RAJ-IITROORKEE/smart-park-design/media/README.md

# SmartPark media

The showcase folder contains a short product film made from the actual RevD CAD previews. The videos folder retains the supplied screen recording unchanged.

## Product showcase

The film presents the final enclosure, carrier and connected electronics, followed by the two case variants and fabrication downloads.

- [Showcase MP4](showcase/brag.mp4)
- [Full resolution poster](showcase/brag.jpg)
- [Animated README preview](showcase/preview.gif)
- [Storyboard and source composition](showcase)

These visuals show the design intent of an unbuilt indoor pilot, not a deployed working product. Music attribution and reproduction details are retained with the composition.

## Original recording

The original supplied project recording is preserved without editing or recompression.

- [SmartPark RevD recording](videos/smartpark-revd-preview.mp4)
- Original filename: `20261026-1720-29.8333173.mp4`
- Copy integrity: [SHA256 verification](../verification/video-copy.json)

The recording is a project media asset. Its contents have not been reviewed for public sharing; inspect it before a future GitHub publication.
