RAJ-IITROORKEE/smart-park-design/lat.md/lat.md

# SmartPark Rev D knowledge index

This index links the project overview, manufacturing flow, and pilot qualification limits.

- [[index]] — Architecture, geometry checks, and electrical source overview.
