RAJ-IITROORKEE/smart-park-design/media/showcase/brag-plan.md

# Brag Plan: SmartPark Revision D

## Planning rubric

1. **What is this?** An indoor ceiling-mounted parking sensor pilot built around a downward-facing HC-SR04, XIAO ESP32S3, and a custom carrier.
2. **Strongest claim:** The design is dimensioned for a ceiling up to 2.8 m above the floor; this is a design limit, not a field-test result.
3. **Visual hook:** The actual assembled CAD render, with its two ultrasonic faces and compact enclosure.
4. **What to show:** Actual product, electronics stack, OLED/status-only variants, PCB copper, and the repository’s fabrication and print downloads.
5. **Shortest satisfying length:** 20.5 seconds: enough for the product, the two build variants, and where to get the design files.
6. **Tone:** Polished; a restrained engineering product film with legible labels and precise motion.
7. **Audio:** A clean instrumental bed with three quiet, motion-matched accents; no narration.
8. **Share caption:** “SmartPark Rev D: an indoor ceiling-mounted parking sensor pilot, with the PCB and case files ready to inspect.”
9. **Real use flow:** Not a software flow. The designed sequence is mount above a bay → measure downward with HC-SR04 → report occupancy over LoRa to a separate receiver/gateway. Firmware and gateway are not included.

## The angle

A precise object study of one indoor parking bay sensor: the finished-looking enclosure opens into its actual electronics, resolves into two real case variants, then lands on the PCB and the build files. The footage presents the retained design as an unbuilt pilot, not a deployed or qualified product.

## Hook (0–3.2s)

Lead with the supplied product_oled.png CAD render. “One bay. Read from above.” appears beside it over a pale technical canvas. The top line identifies SmartPark Rev D and labels the work an indoor pilot.

## Key moments

- The supplied status-only housing and a dimension marker anchor the 2.8 m indoor ceiling design envelope.
- The real exploded enclosure and electronics-stack renders show how the carrier, modules, battery, and case relate.
- Two actual case renders arrive in sequence: OLED (7 printed parts), then status-only (6 printed parts).
- The actual PCB front/back previews lead to Gerbers, KiCad sources, and case-print files.

## Outro

Show the real PCB copper views, then hold the repository address with “Rev D · indoor pilot” and “Unbuilt design · firmware and gateway not included.”

## Tone and format

- Preset: polished
- Creative direction: calm, measured engineering product film
- Interpretation: long enough to inspect the real models; crisp type, short labels, restrained teal accents, and motion that feels deliberate rather than dramatic.
- Format: landscape — 1920 × 1080
- Duration: 20.5 seconds
- Visual identity: cool light background #EEF3F5; navy #183849; teal #168B8D; body #395461; fine rules #A9BEC3.
- Display font: Playfair Display; body: Montserrat; technical labels: IBM Plex Mono.
- Strongest source visuals: the supplied CAD assembly and PCB copper renders in previews/05-images/ and previews/01-pcb/.
- No live app UI exists. The product visual is the source CAD.
- Claims to avoid: built, deployed, production-ready, weatherproof/IP-rated, measured battery life, working firmware, included gateway, field performance.

## Share copy (draft)

SmartPark Rev D: an indoor ceiling-mounted parking sensor pilot, with the PCB and case files ready to inspect.

## Audio direction

- Role: understated polished bed with a few soft reveal accents.
- Music: “Happy Beats & Business Moves Vol. 12” by Sascha Ende, copied from the bundled /brag assets.
- Music treatment: fade in briefly, sit below the product visuals, fade out on the closing card.
- Music cue guidance: bundled preset happy-beats-business-moves-vol-12-by-ende-dot-app.music-cues.json, 109.96 BPM. Lock the electronics-stack reveal near 8.74s, the second case variant near 13.11s, and PCB/download reveal near 17.47s. For the two case cards, use nearby grid beats at 12.02s and 13.11s; both labels remain visible afterward. Keep the smaller image and rule motions natural.
- Audio treatment: music sets pacing and transitions; animation stays calm and non-reactive. No waveform or equalizer graphics.
- SFX posture: sparse; three soft, warm accents on product, stack, and final PCB reveals.
- Restraint rule: music and sounds support the real objects; no hype impacts or synthetic sensor beeps.

## Storyboard

### Scene 1 — One bay — 3.2s
The actual OLED product render fills the right half; the hook and “SMARTPARK / REV D · INDOOR PILOT” sit left. A measured rule pulls the eye toward the two downward-facing sensor apertures. The headline enters quickly and holds for at least 2s.
Sequential/interaction: none.
Audio intent: music begins softly; one low, warm reveal accent.
Audio-coupled idea: subtle background warmth only.
Transition mood: clean slide → Scene 2.

### Scene 2 — Ceiling mount — 3.9s
The actual status-only product render is paired with “Designed for indoor ceilings up to 2.8 m.” A simple measurement rule clarifies the sensor-to-floor orientation without depicting a live parking result.
Sequential/interaction: none.
Audio intent: let the bed carry the hold.
Audio-coupled idea: none.
Transition mood: soft crossfade → Scene 3.

### Scene 3 — Inside the enclosure — 4.4s
The actual exploded OLED enclosure resolves into the real electronics stack. Labels name XIAO ESP32S3, Wio-SX1262, HC-SR04, and protected 1S LiPo. “62 × 50 mm carrier” describes the PCB; no assembled/operating state is implied.
Sequential/interaction: component labels appear as one readable set.
Audio intent: quiet accent on the stack reveal.
Audio-coupled idea: land the main reveal near the 8.74s strong cue.
Transition mood: clean slide → Scene 4.

### Scene 4 — Two case variants — 4.2s
The supplied OLED and status-only case renders arrive one at a time; parts-review.png supports the real printed-part layout. Captions: “OLED · 7 printed parts” and “Status-only · 6 printed parts.” The first label remains visible when the second arrives.
Sequential/interaction: OLED card at about 12.02s, status-only card near the 13.11s strong cue; keep both labels on screen through the cut.
Audio intent: one light accent on the second variant.
Audio-coupled idea: the two visual entries use the nearby cue grid without rushing text.
Transition mood: clean slide → Scene 5.

### Scene 5 — Files to build from — 4.8s
Actual PCB front/back copper renders flank “Gerbers · KiCad · case prints.” Hold github.com/RAJ-IITROORKEE/smart-park-design, “Rev D · indoor pilot,” and “Unbuilt design · firmware and gateway not included.” Music credit sits quietly in the footer.
Sequential/interaction: files arrive as one stable set.
Audio intent: final soft resolve and short music fade.
Audio-coupled idea: land the board/download reveal near 17.47s.
Transition mood: settle and hold through 20.5s.

**Music mood:** optimistic, clean, quiet under the visuals.
**Audio summary:** A soft instrumental bed follows the reveal from product to board, with three restrained accents and a short final fade.
