RAJ-IITROORKEE/smart-park-design/cad/renders/base.png

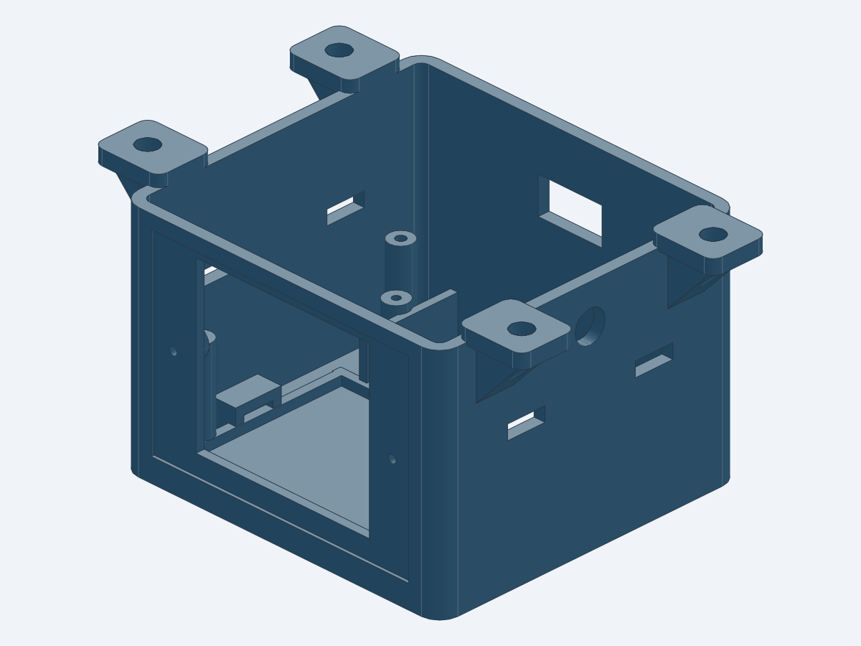
cad/renders/base.png
