RAJ-IITROORKEE/smart-park-design/cad/renders/exploded_status.png

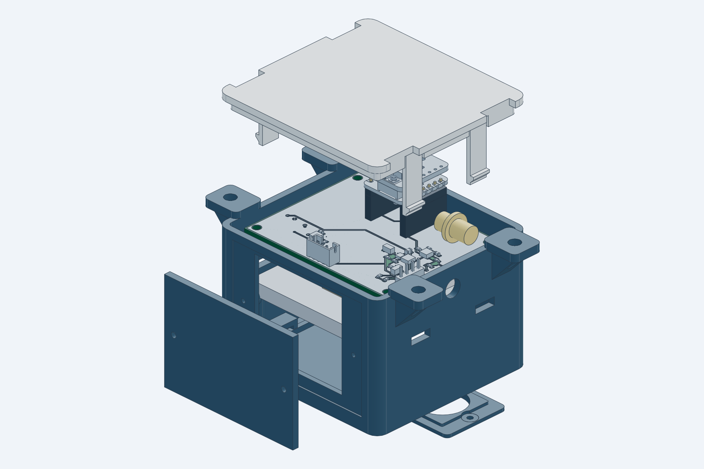
cad/renders/exploded_status.png
