RAJ-IITROORKEE/smart-park-design/cad/renders/fit_coupon.png

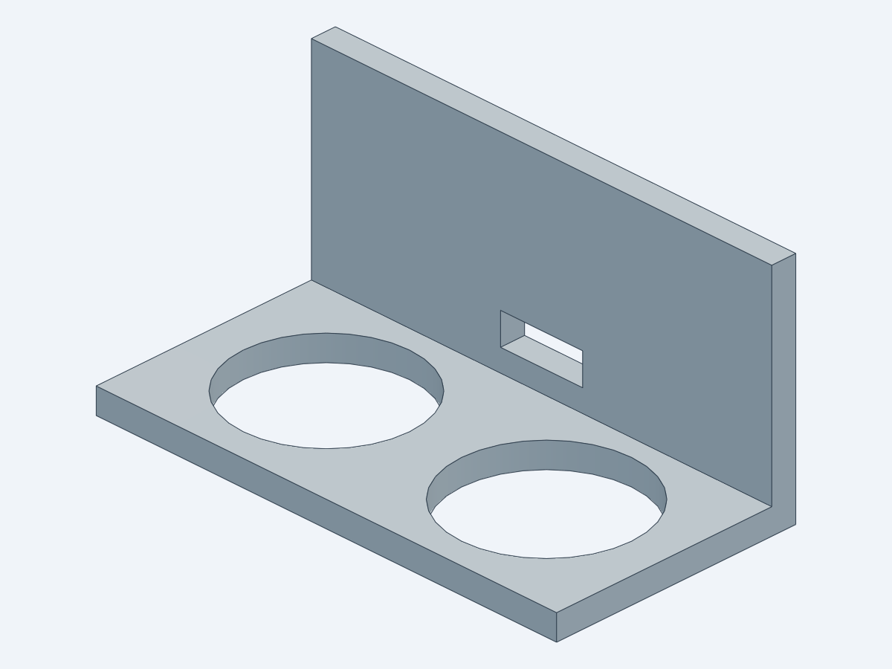
cad/renders/fit_coupon.png
