RAJ-IITROORKEE/smart-park-design/cad/renders/front_blank.png

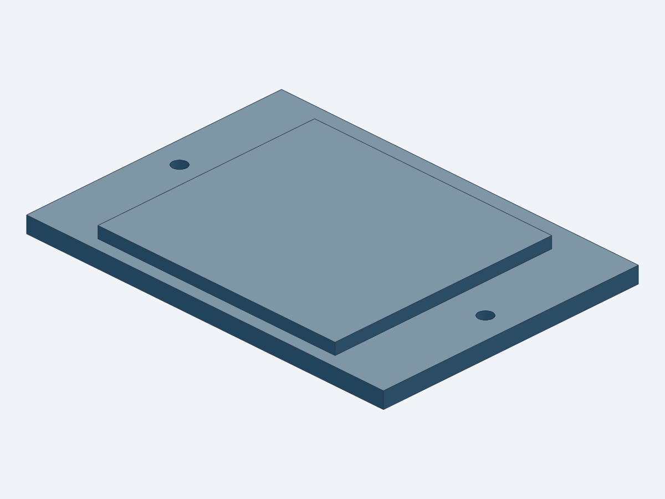
cad/renders/front_blank.png
