RAJ-IITROORKEE/smart-park-design/cad/renders/lid.png

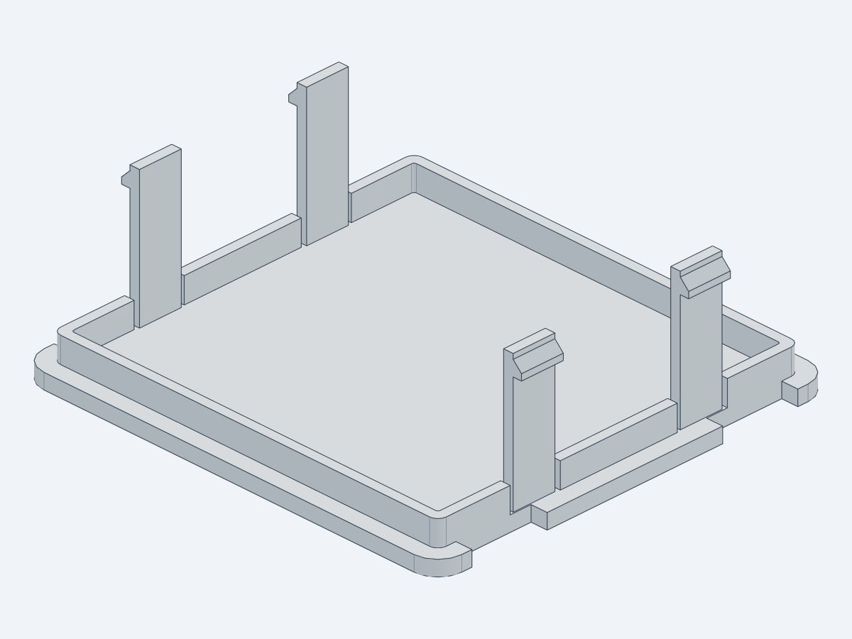
cad/renders/lid.png
