RAJ-IITROORKEE/smart-park-design/cad/renders/light_pipe.png

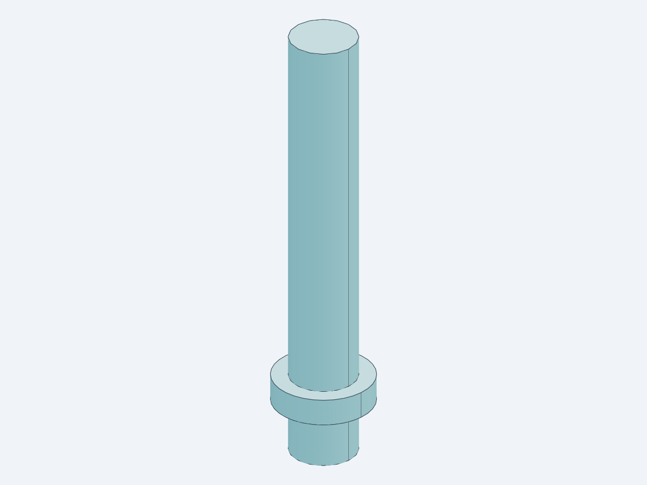
cad/renders/light_pipe.png
