RAJ-IITROORKEE/smart-park-design/cad/renders/oled_retainer.png

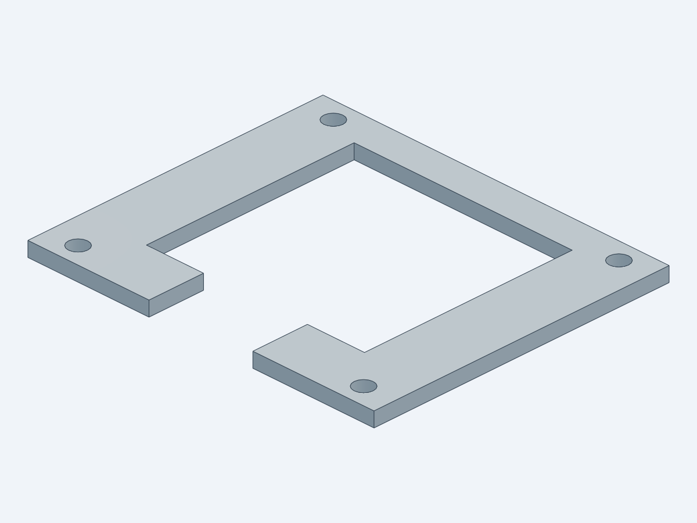
cad/renders/oled_retainer.png
