RAJ-IITROORKEE/smart-park-design/cad/renders/sensor_mask.png

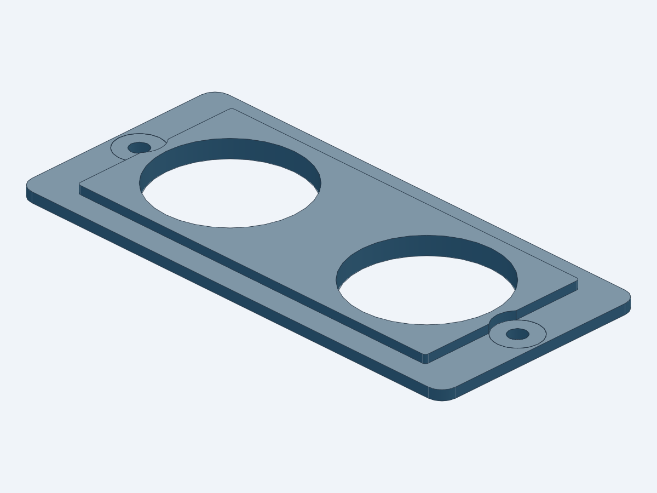
cad/renders/sensor_mask.png
