RAJ-IITROORKEE/smart-park-design/cad/renders/sensor_retainer.png

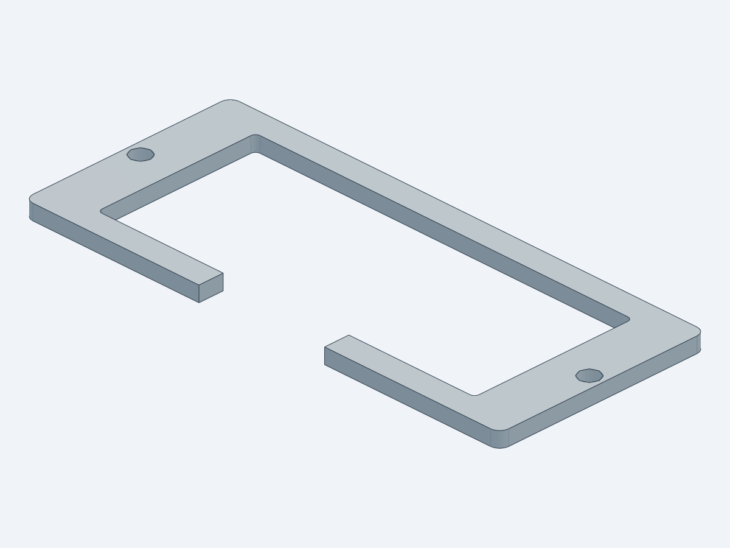
cad/renders/sensor_retainer.png
