RAJ-IITROORKEE/smart-park-design/docs/sources/goldenmorning-page4.png

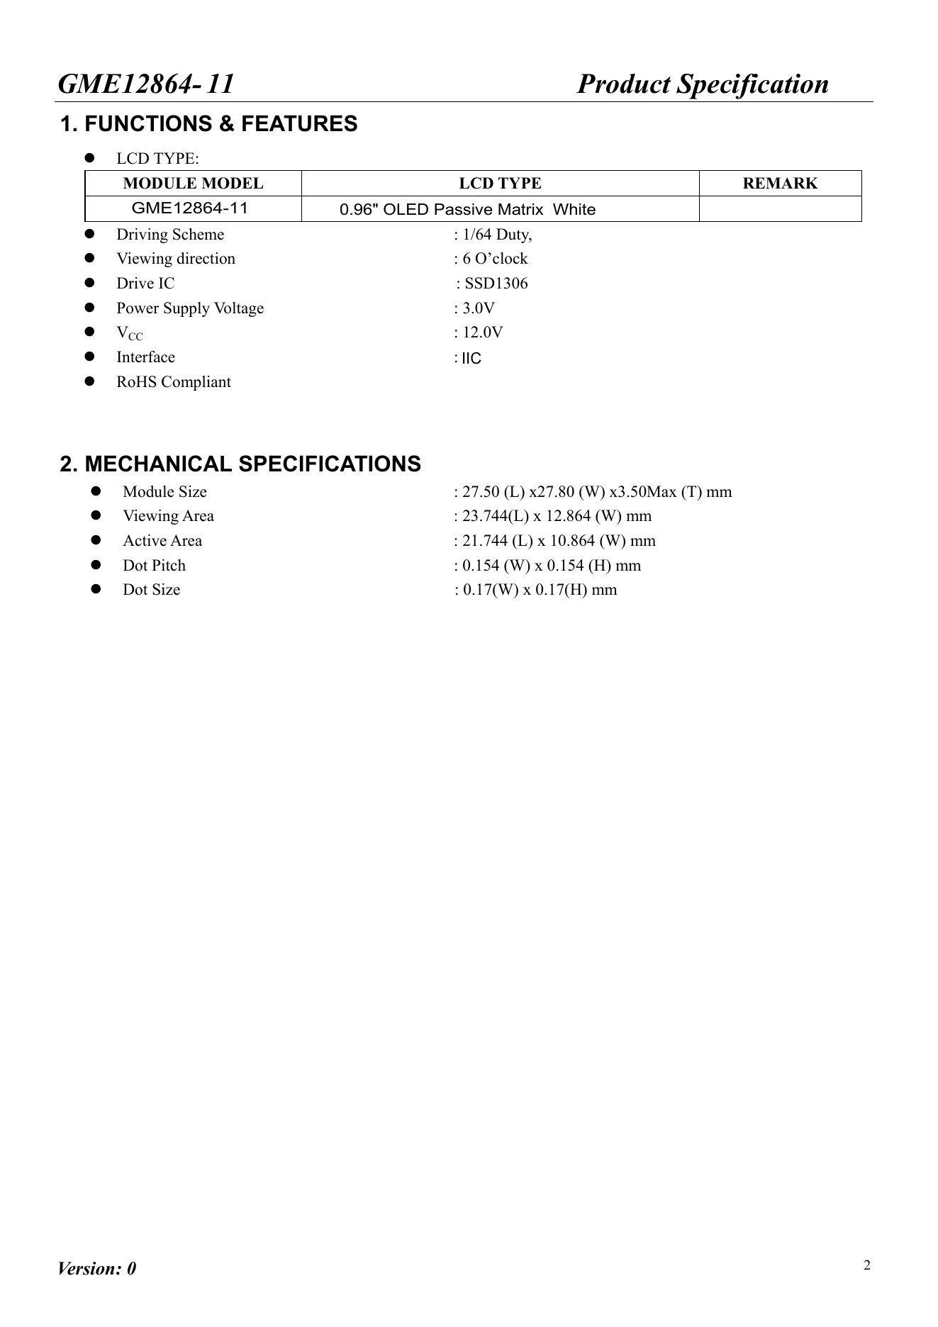
docs/sources/goldenmorning-page4.png
