RAJ-IITROORKEE/smart-park-design/docs/sources/goldenmorning-page5.png

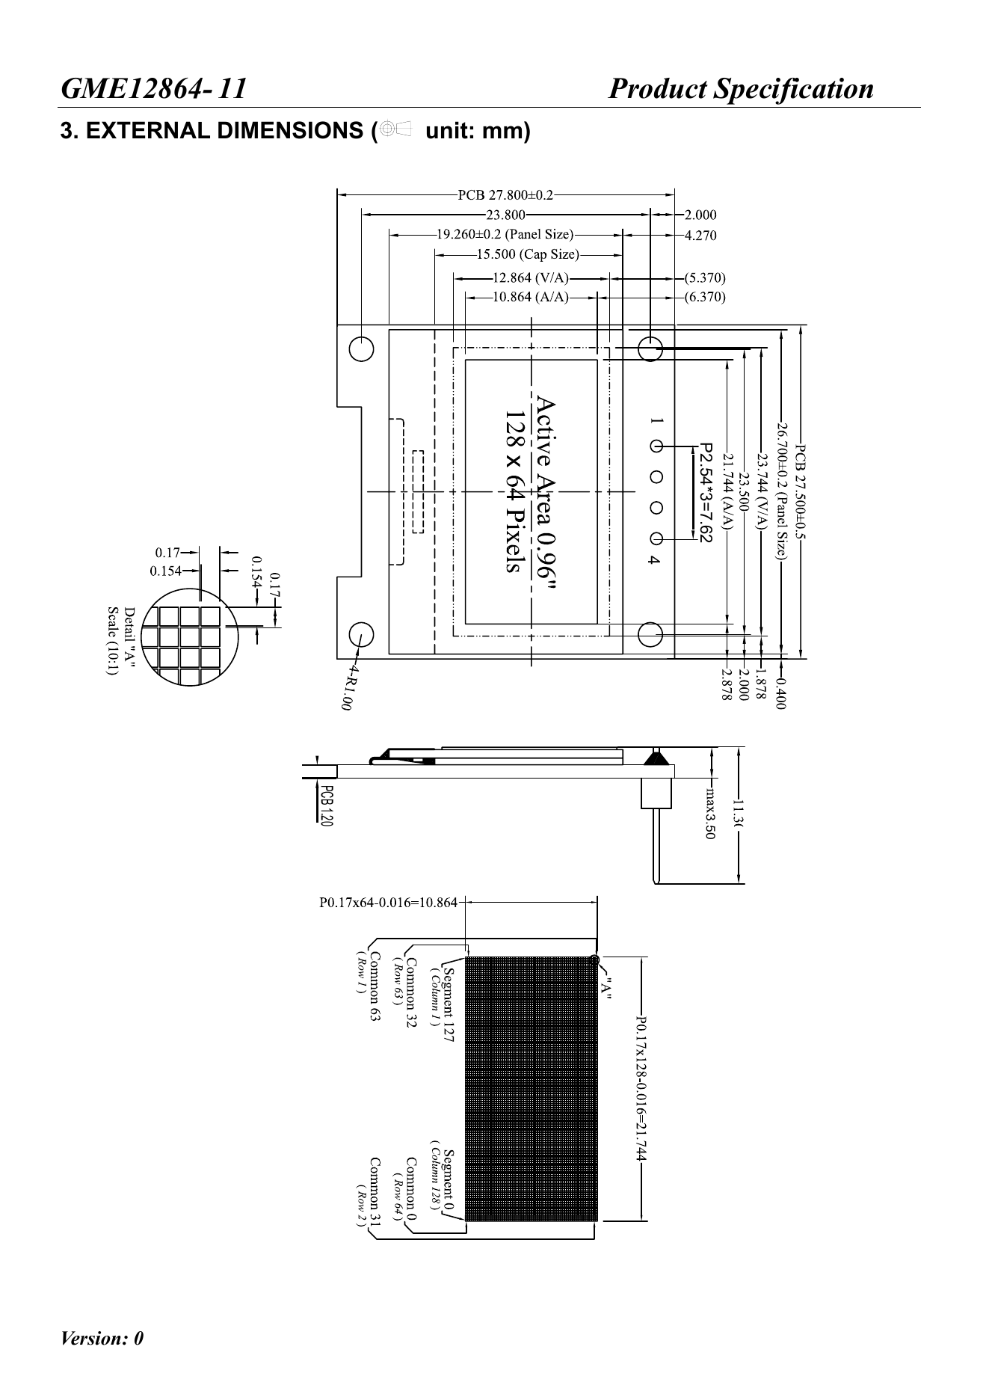
docs/sources/goldenmorning-page5.png
