RAJ-IITROORKEE/smart-park-design/docs/sources/robu-hcsr04-page1.png

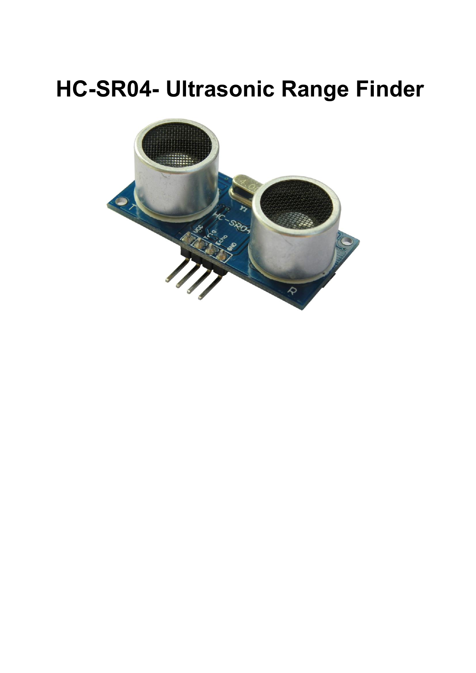
docs/sources/robu-hcsr04-page1.png
