RAJ-IITROORKEE/smart-park-design/docs/sources/robu-hcsr04-page3.png

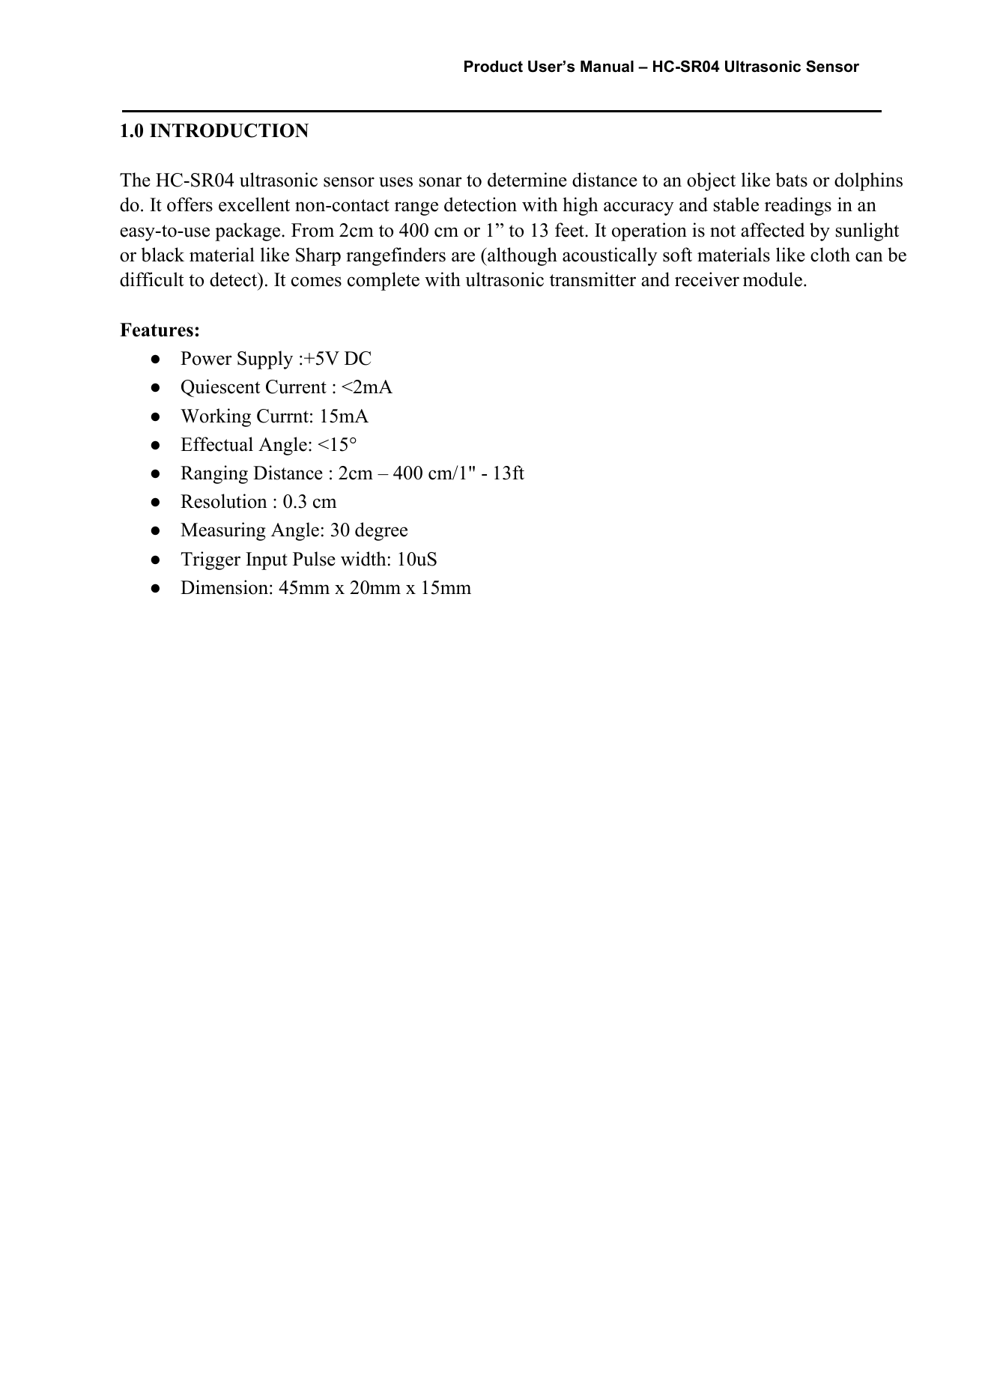
docs/sources/robu-hcsr04-page3.png
