RAJ-IITROORKEE/smart-park-design/media/showcase/brag.jpg

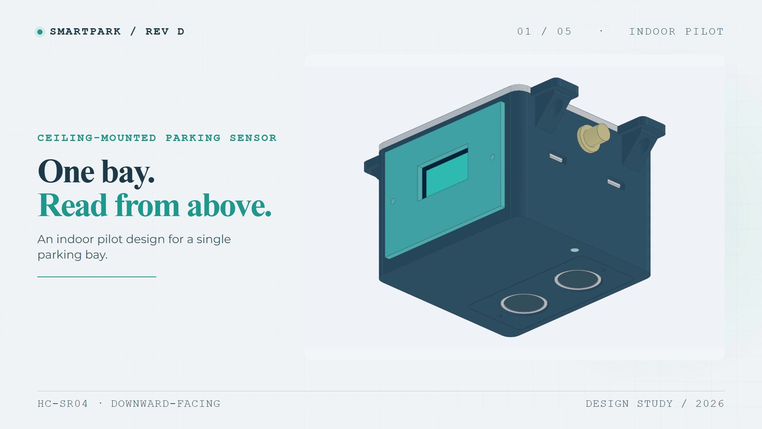
media/showcase/brag.jpg
