RAJ-IITROORKEE/smart-park-design/outputs/schematics.png

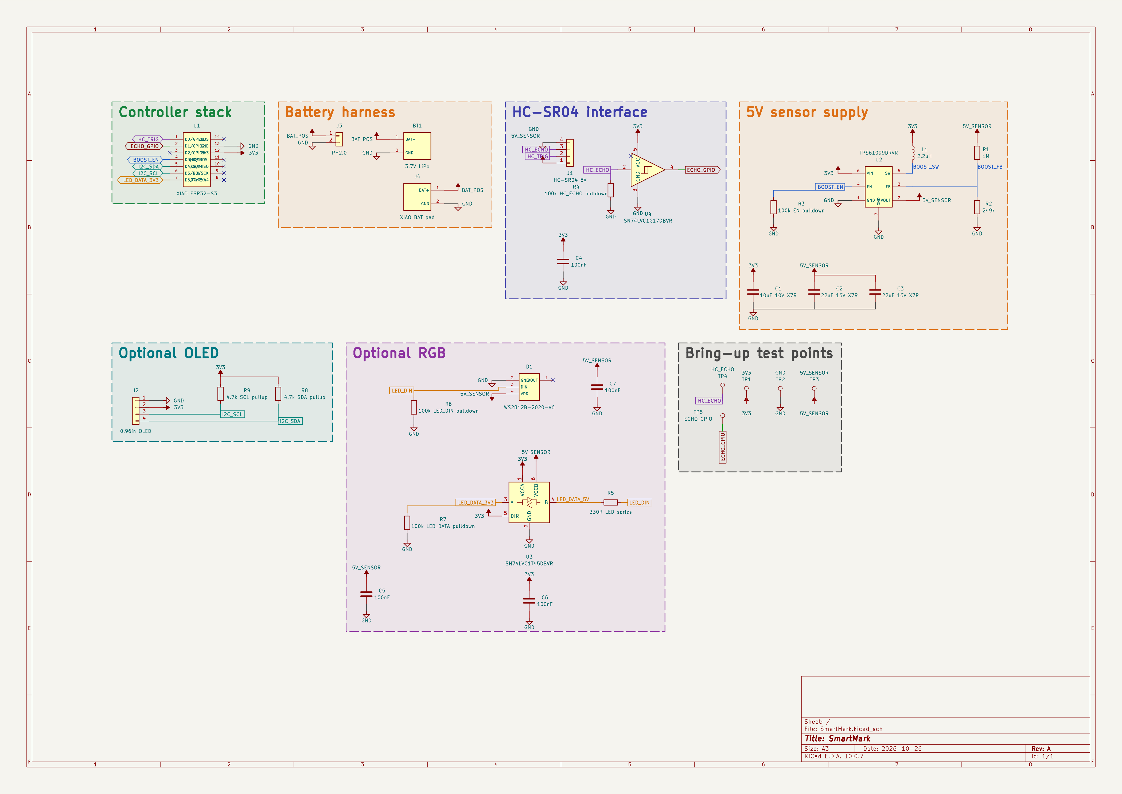
outputs/schematics.png
