RAJ-IITROORKEE/smart-park-design/previews/05-images/case-no-oled.png

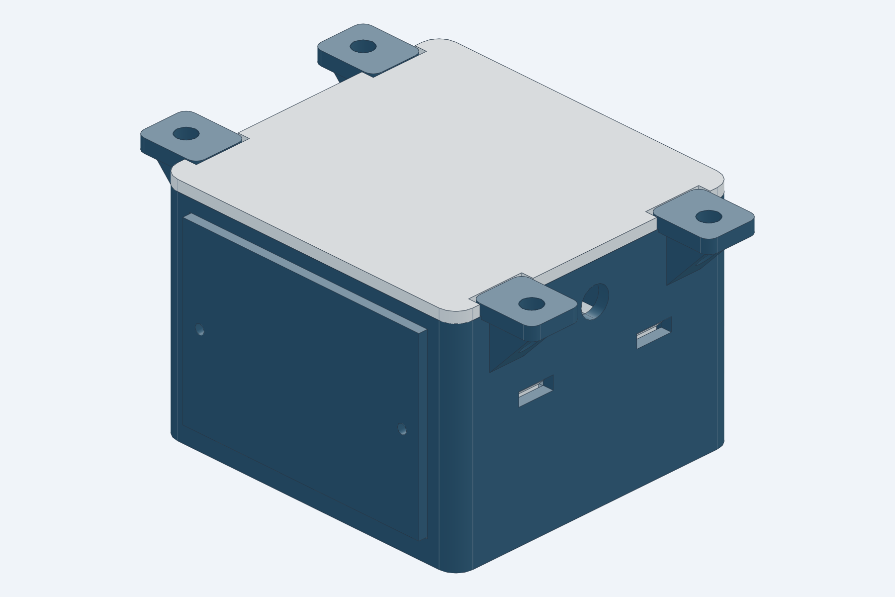
previews/05-images/case-no-oled.png
