RAJ-IITROORKEE/smart-park-design/previews/05-images/case-oled.png

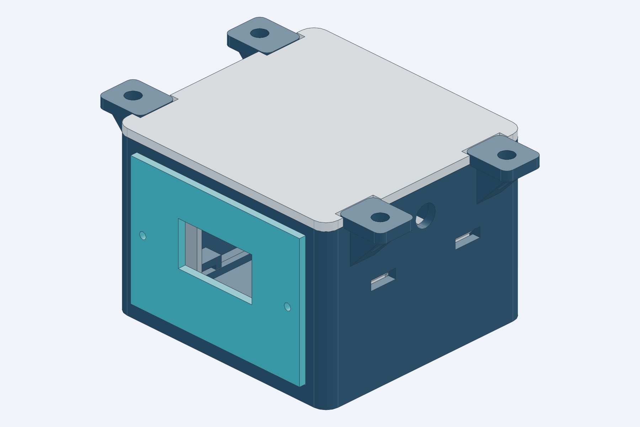
previews/05-images/case-oled.png
