RAJ-IITROORKEE/smart-park-design/cad/imported/xiao-s3-wio-sx1262-stack.step

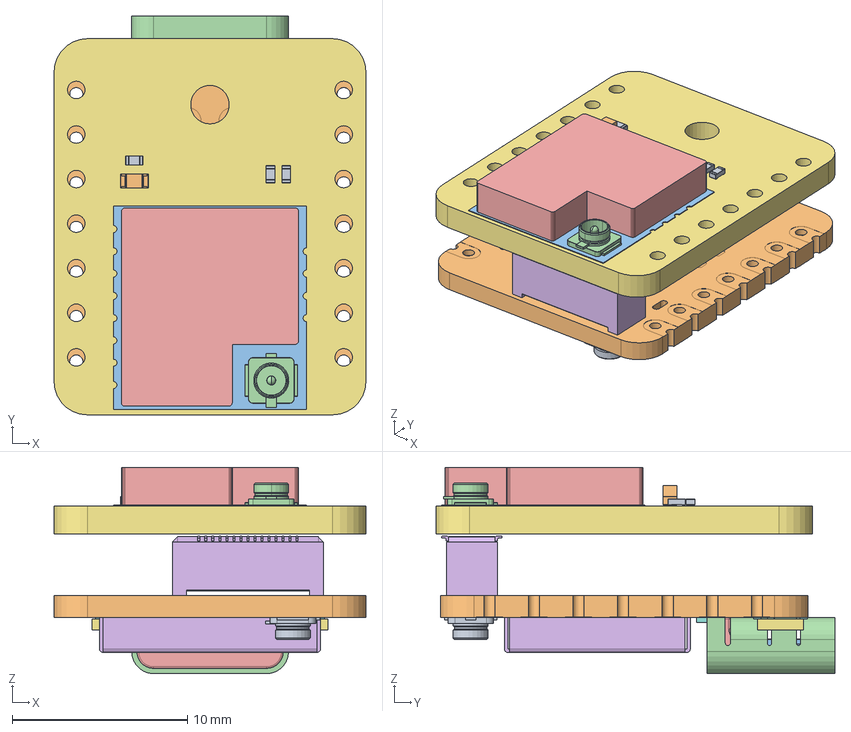
[picture p28: CAD file, 2026-10-26]
cad/imported/xiao-s3-wio-sx1262-stack.step
17.8 x 22.7 x 11.8 mm
