RAJ-IITROORKEE/smart-park-design/cad/STEP/oled_retainer.step

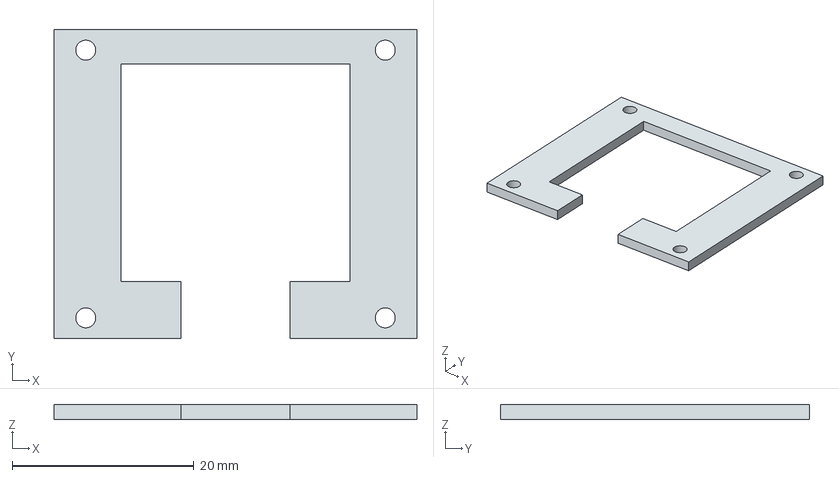
[picture p29: CAD file, 2026-10-26]
cad/STEP/oled_retainer.step
40.0 x 34.1 x 1.60 mm
