RAJ-IITROORKEE/smart-park-design/outputs/board.step

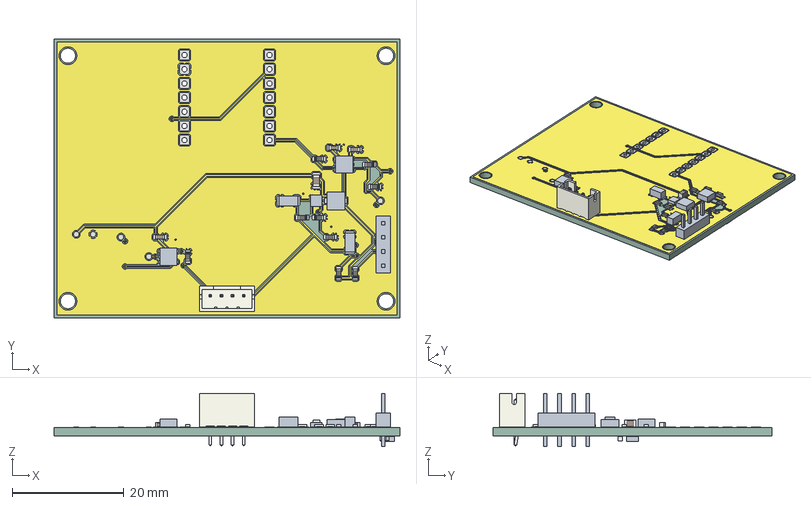
[picture p30: CAD file, 2026-10-26]
outputs/board.step
62.0 x 50.0 x 9.50 mm
C_0603_1608Metric x 4
R_0603_1608Metric x 9
JST_B4B_PH_K
C_0805_2012Metric
SmartMark_copper
SmartMark_pad
SmartMark_via
SmartMark_PCB
