RAJ-IITROORKEE/smart-park-design/cad/STEP/front_oled.step

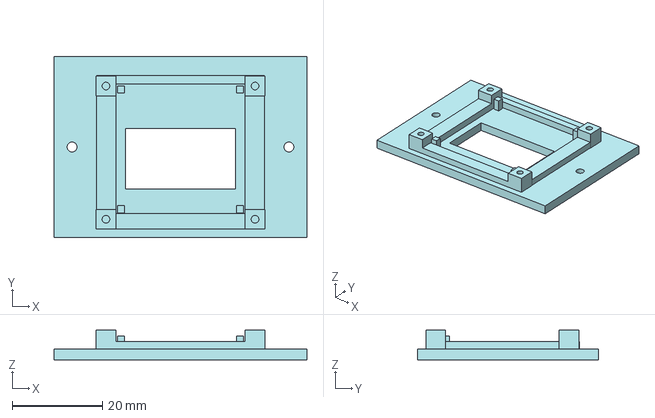
[picture p34: CAD file, 2026-10-26]
cad/STEP/front_oled.step
56.0 x 40.0 x 6.60 mm
