RAJ-IITROORKEE/smart-park-design/previews/03-enclosure/case-no-oled.step

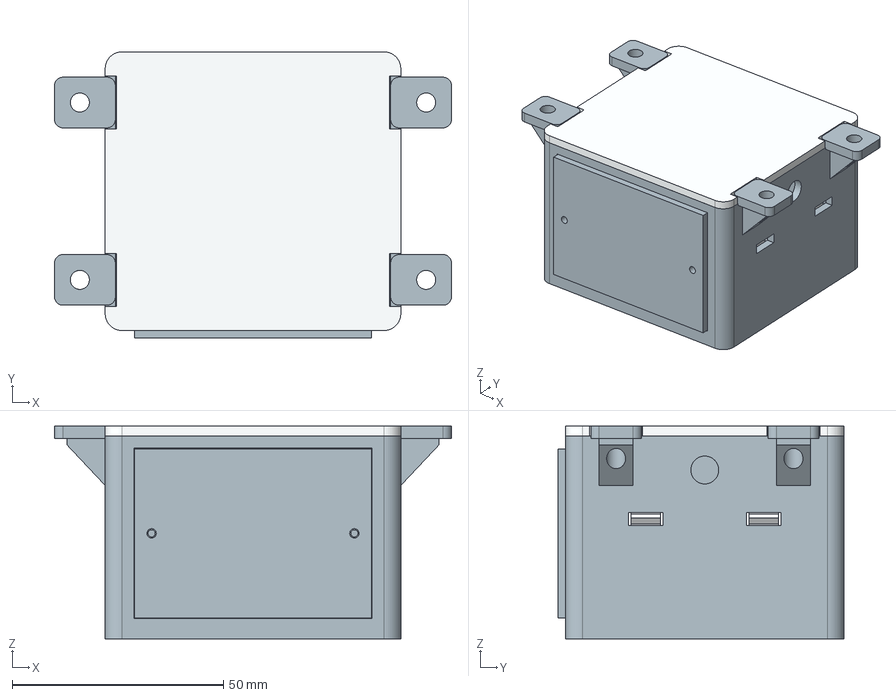
[picture p35: CAD file, 2026-10-26]
previews/03-enclosure/case-no-oled.step
94.0 x 67.8 x 50.4 mm
Main shell - indoor pilot
Replaceable HC-SR04 acoustic mask - nominal 26mm pitch
HC-SR04 edge retainer
Clear PETG status light pipe
Snap lid - four release clips
Blank front panel
