RAJ-IITROORKEE/smart-park-design/previews/04-complete-product/product_oled.step

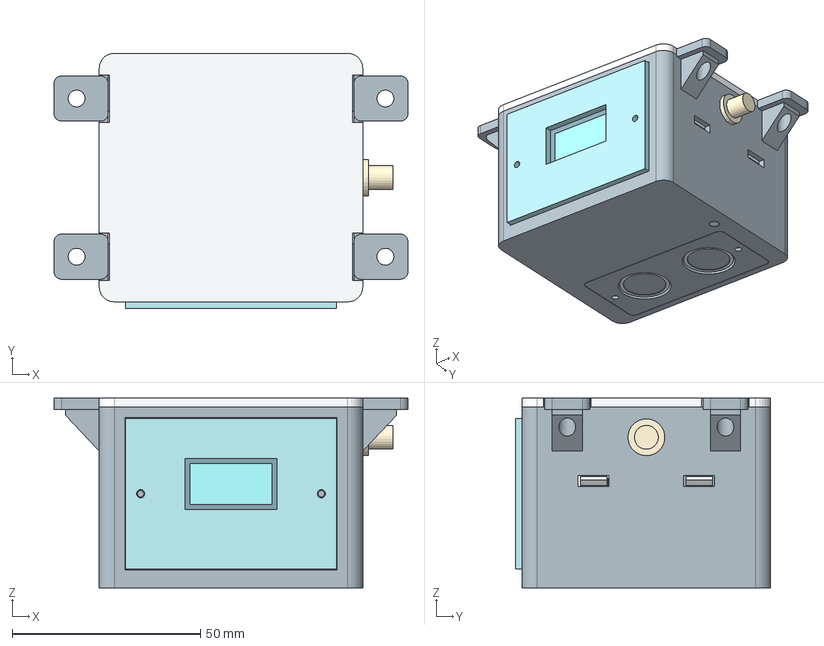
[picture p36: CAD file, 2026-10-26]
previews/04-complete-product/product_oled.step
94.0 x 67.8 x 50.4 mm
Main shell - indoor pilot
Replaceable HC-SR04 acoustic mask - nominal 26mm pitch
HC-SR04 edge retainer
=>[0:1:1:3] x 4
=>[0:1:1:5] x 9
=>[0:1:1:7]
=>0:1:1:10 x 2
=>[0:1:1:12]
=>0:1:1:15
=>0:1:1:18
=>0:1:1:21
=>0:1:1:24
=>0:1:1:25
=>0:1:1:26
=>0:1:1:27
=>0:1:1:28
=>0:1:1:31
=>0:1:1:34
=>[0:1:1:35]
=>[0:1:1:36]
=>[0:1:1:37]
=>[0:1:1:38]
o1.1.1
o1.1.2
o1.1.3
o1.1.4
o1.1.5.1.1
o1.1.5.1.2
o1.1.5.1.3
o1.1.6
o1.1.7
o1.2.1.1.1.1
o1.2.1.1.1.2
o1.2.1.1.1.3
o1.2.1.1.1.4
o1.2.1.1.1.5
o1.2.1.1.1.6
o1.2.1.1.1.7
o1.2.1.1.1.8
o1.2.1.1.1.9
o1.2.1.1.1.10
o1.2.1.1.1.11
o1.2.1.1.1.12
o1.2.1.1.1.13
o1.2.1.1.1.14
o1.2.1.1.1.15
o1.2.1.1.1.16
o1.2.1.1.1.17
o1.2.1.1.1.18
o1.2.1.1.1.19
o1.2.1.1.1.20
o1.2.1.1.1.21
o1.2.1.1.1.22
o1.2.1.1.1.23
o1.2.1.1.1.24
o1.2.1.2
o1.2.1.3.1
o1.2.1.3.2.1
o1.2.1.3.2.2
o1.2.1.3.2.3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
