RAJ-IITROORKEE/smart-park-design/cad/STEP/sensor_retainer.step

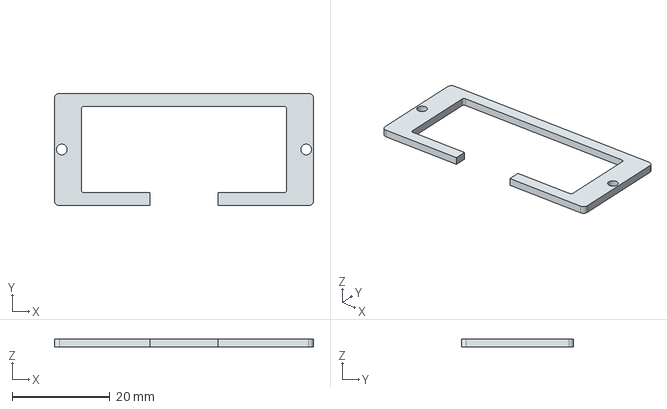
[picture p37: CAD file, 2026-10-26]
cad/STEP/sensor_retainer.step
53.0 x 23.0 x 1.60 mm
