RAJ-IITROORKEE/smart-park-design/cad/STEP/fit_coupon.step

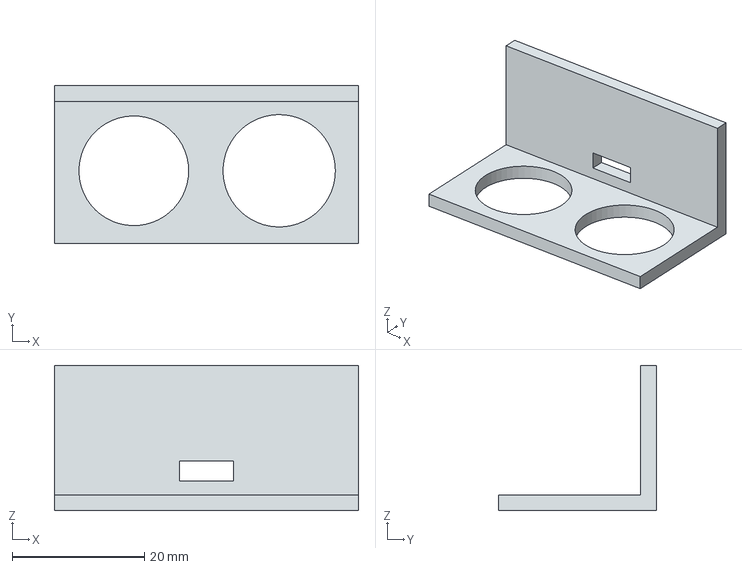
[picture p40: CAD file, 2026-10-26]
cad/STEP/fit_coupon.step
46.0 x 23.9 x 22.0 mm
