RAJ-IITROORKEE/smart-park-design/cad/STEP/sensor_mask.step

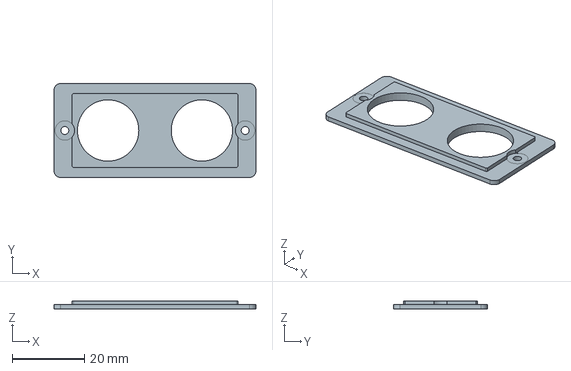
[picture p41: CAD file, 2026-10-26]
cad/STEP/sensor_mask.step
56.0 x 26.0 x 2.20 mm
