RAJ-IITROORKEE/smart-park-design/cad/STEP/lid.step

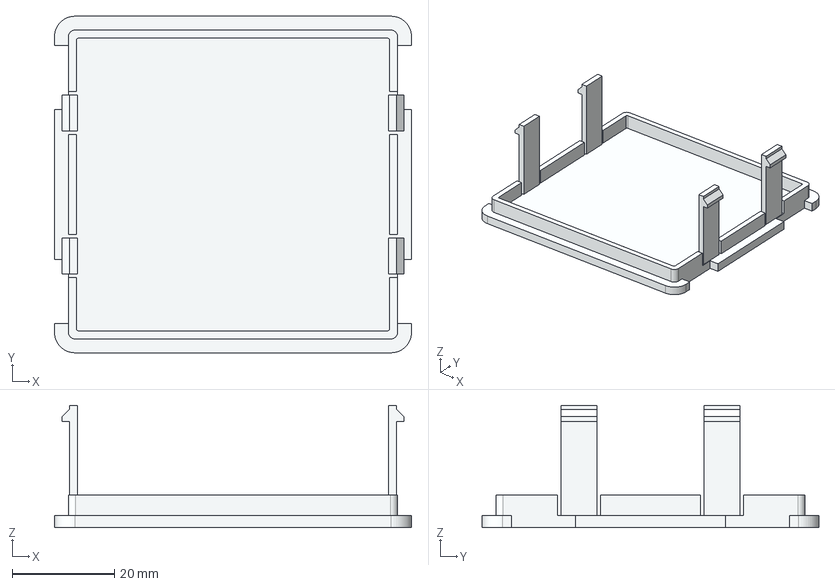
[picture p42: CAD file, 2026-10-26]
cad/STEP/lid.step
70.0 x 66.0 x 24.0 mm
