RAJ-IITROORKEE/smart-park-design/cad/STEP/light_pipe.step

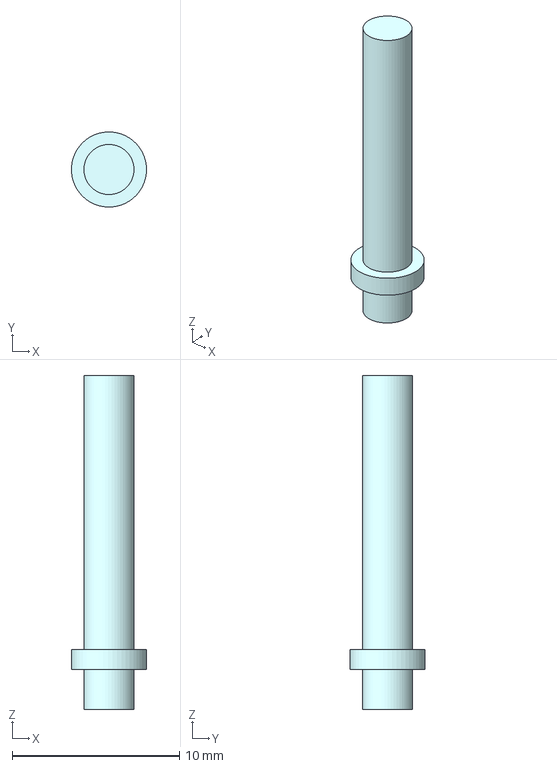
[picture p43: CAD file, 2026-10-26]
cad/STEP/light_pipe.step
4.50 x 4.50 x 20.0 mm
