RAJ-IITROORKEE/smart-park-design/cad/STEP/base.step

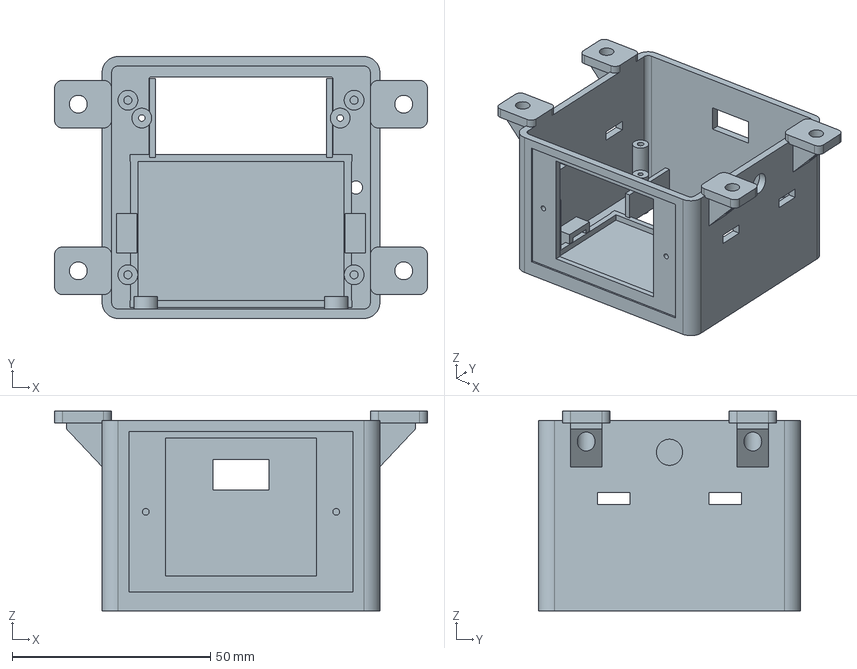
[picture p44: CAD file, 2026-10-26]
cad/STEP/base.step
94.0 x 66.0 x 50.4 mm
