RAJ-IITROORKEE/smart-park-design/cad/STEP/front_blank.step

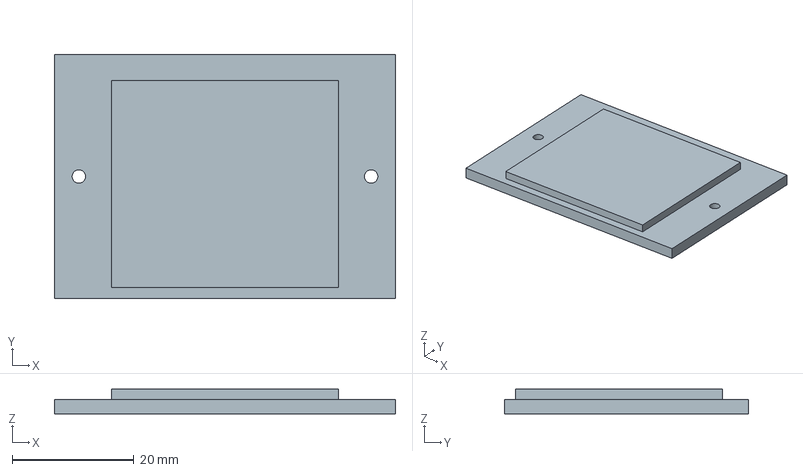
[picture p45: CAD file, 2026-10-26]
cad/STEP/front_blank.step
56.0 x 40.0 x 4.10 mm
