RAJ-IITROORKEE/smart-park-design/(list of files, cad)

Other CAD files:
cad/3MF/base.3mf
cad/3MF/fit_coupon.3mf
cad/3MF/front_blank.3mf
cad/3MF/front_oled.3mf
cad/3MF/lid.3mf
cad/3MF/light_pipe.3mf
cad/3MF/oled_retainer.3mf
cad/3MF/sensor_mask.3mf
cad/3MF/sensor_retainer.3mf
cad/STL/base.stl
cad/STL/fit_coupon.stl
cad/STL/front_blank.stl
cad/STL/front_oled.stl
cad/STL/lid.stl
cad/STL/light_pipe.stl
cad/STL/oled_retainer.stl
cad/STL/sensor_mask.stl
cad/STL/sensor_retainer.stl
