RAJ-IITROORKEE/smart-park-design/outputs/assembly-bottom.png

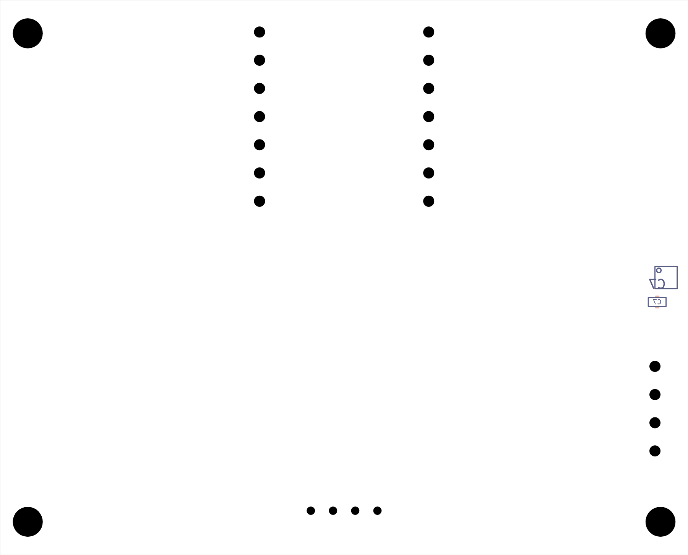
outputs/assembly-bottom.png
