RAJ-IITROORKEE/smart-park-design/outputs/assembly-top.png

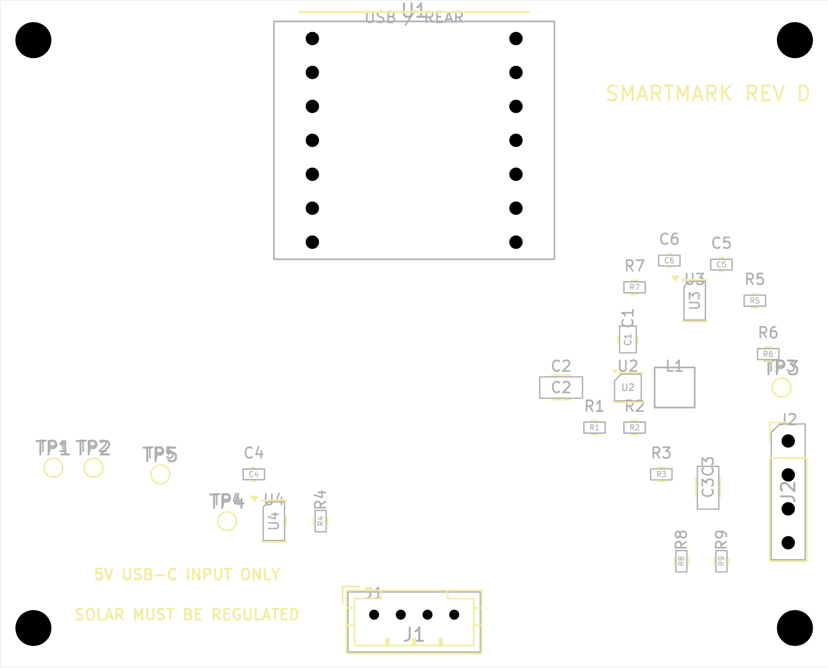
outputs/assembly-top.png
