RAJ-IITROORKEE/smart-park-design/outputs/schematics.pdf

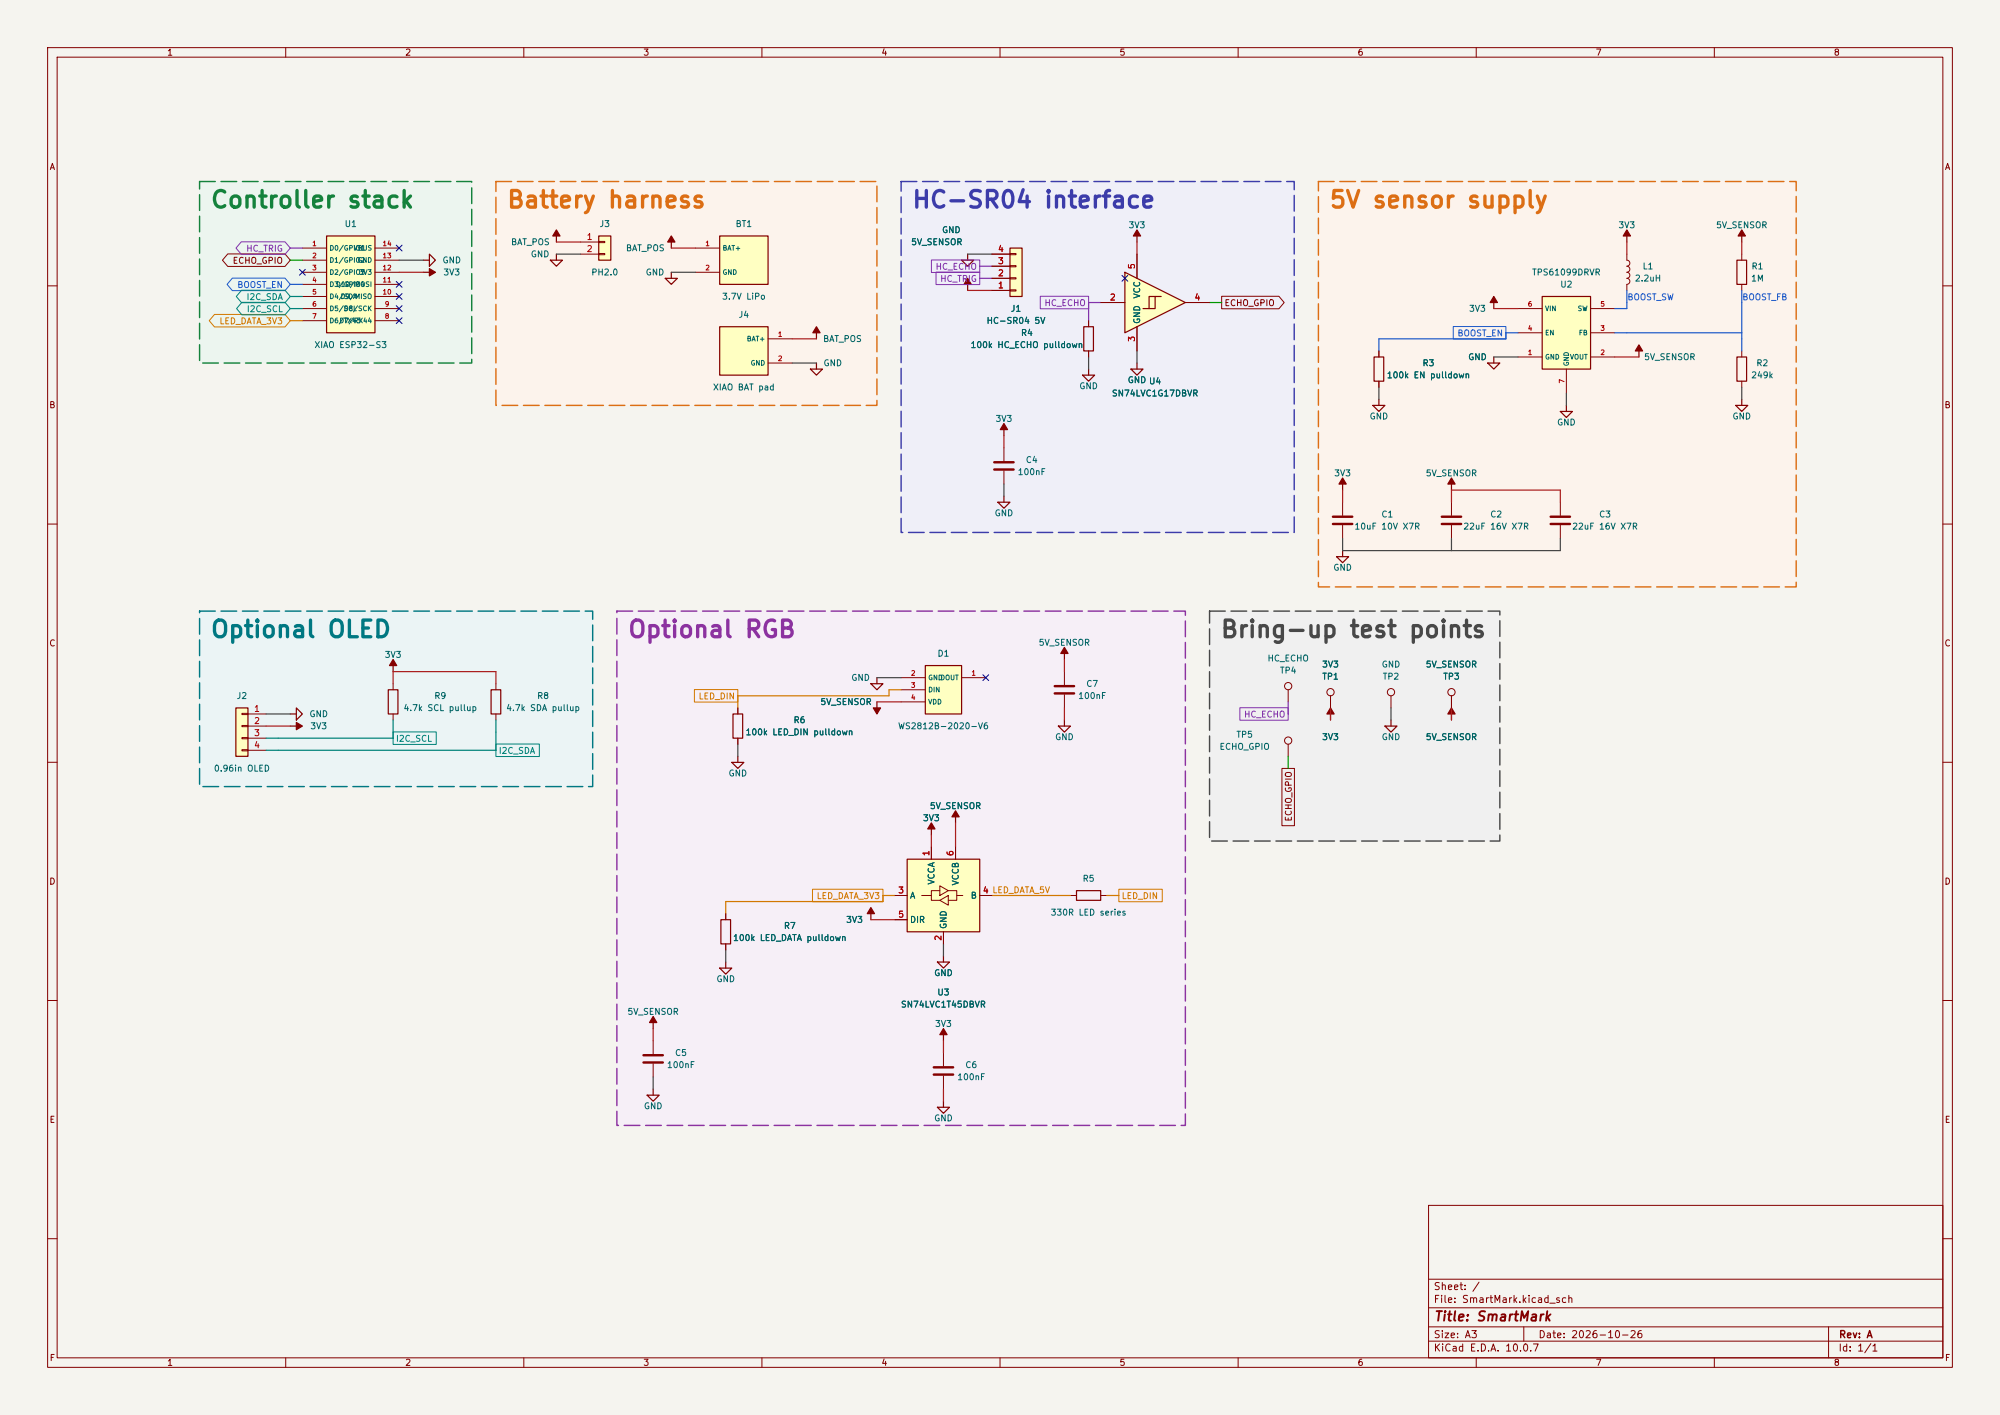
[picture p48: page 1]

Bring-up test points

Size: A3 | Rev: A | F Date: 2026-10-26
KiCad E.D.A. 10.0.7 | Id: 1/1
