RAJ-IITROORKEE/smart-park-design/(list of files, drawings)

Other design files:
hardware/SmartMark.dsn
