RAJ-IITROORKEE/smart-park-design/hardware/SmartMark.kicad_pcb

## KiCad design hardware/SmartMark.kicad_pcb (2026-10-26)

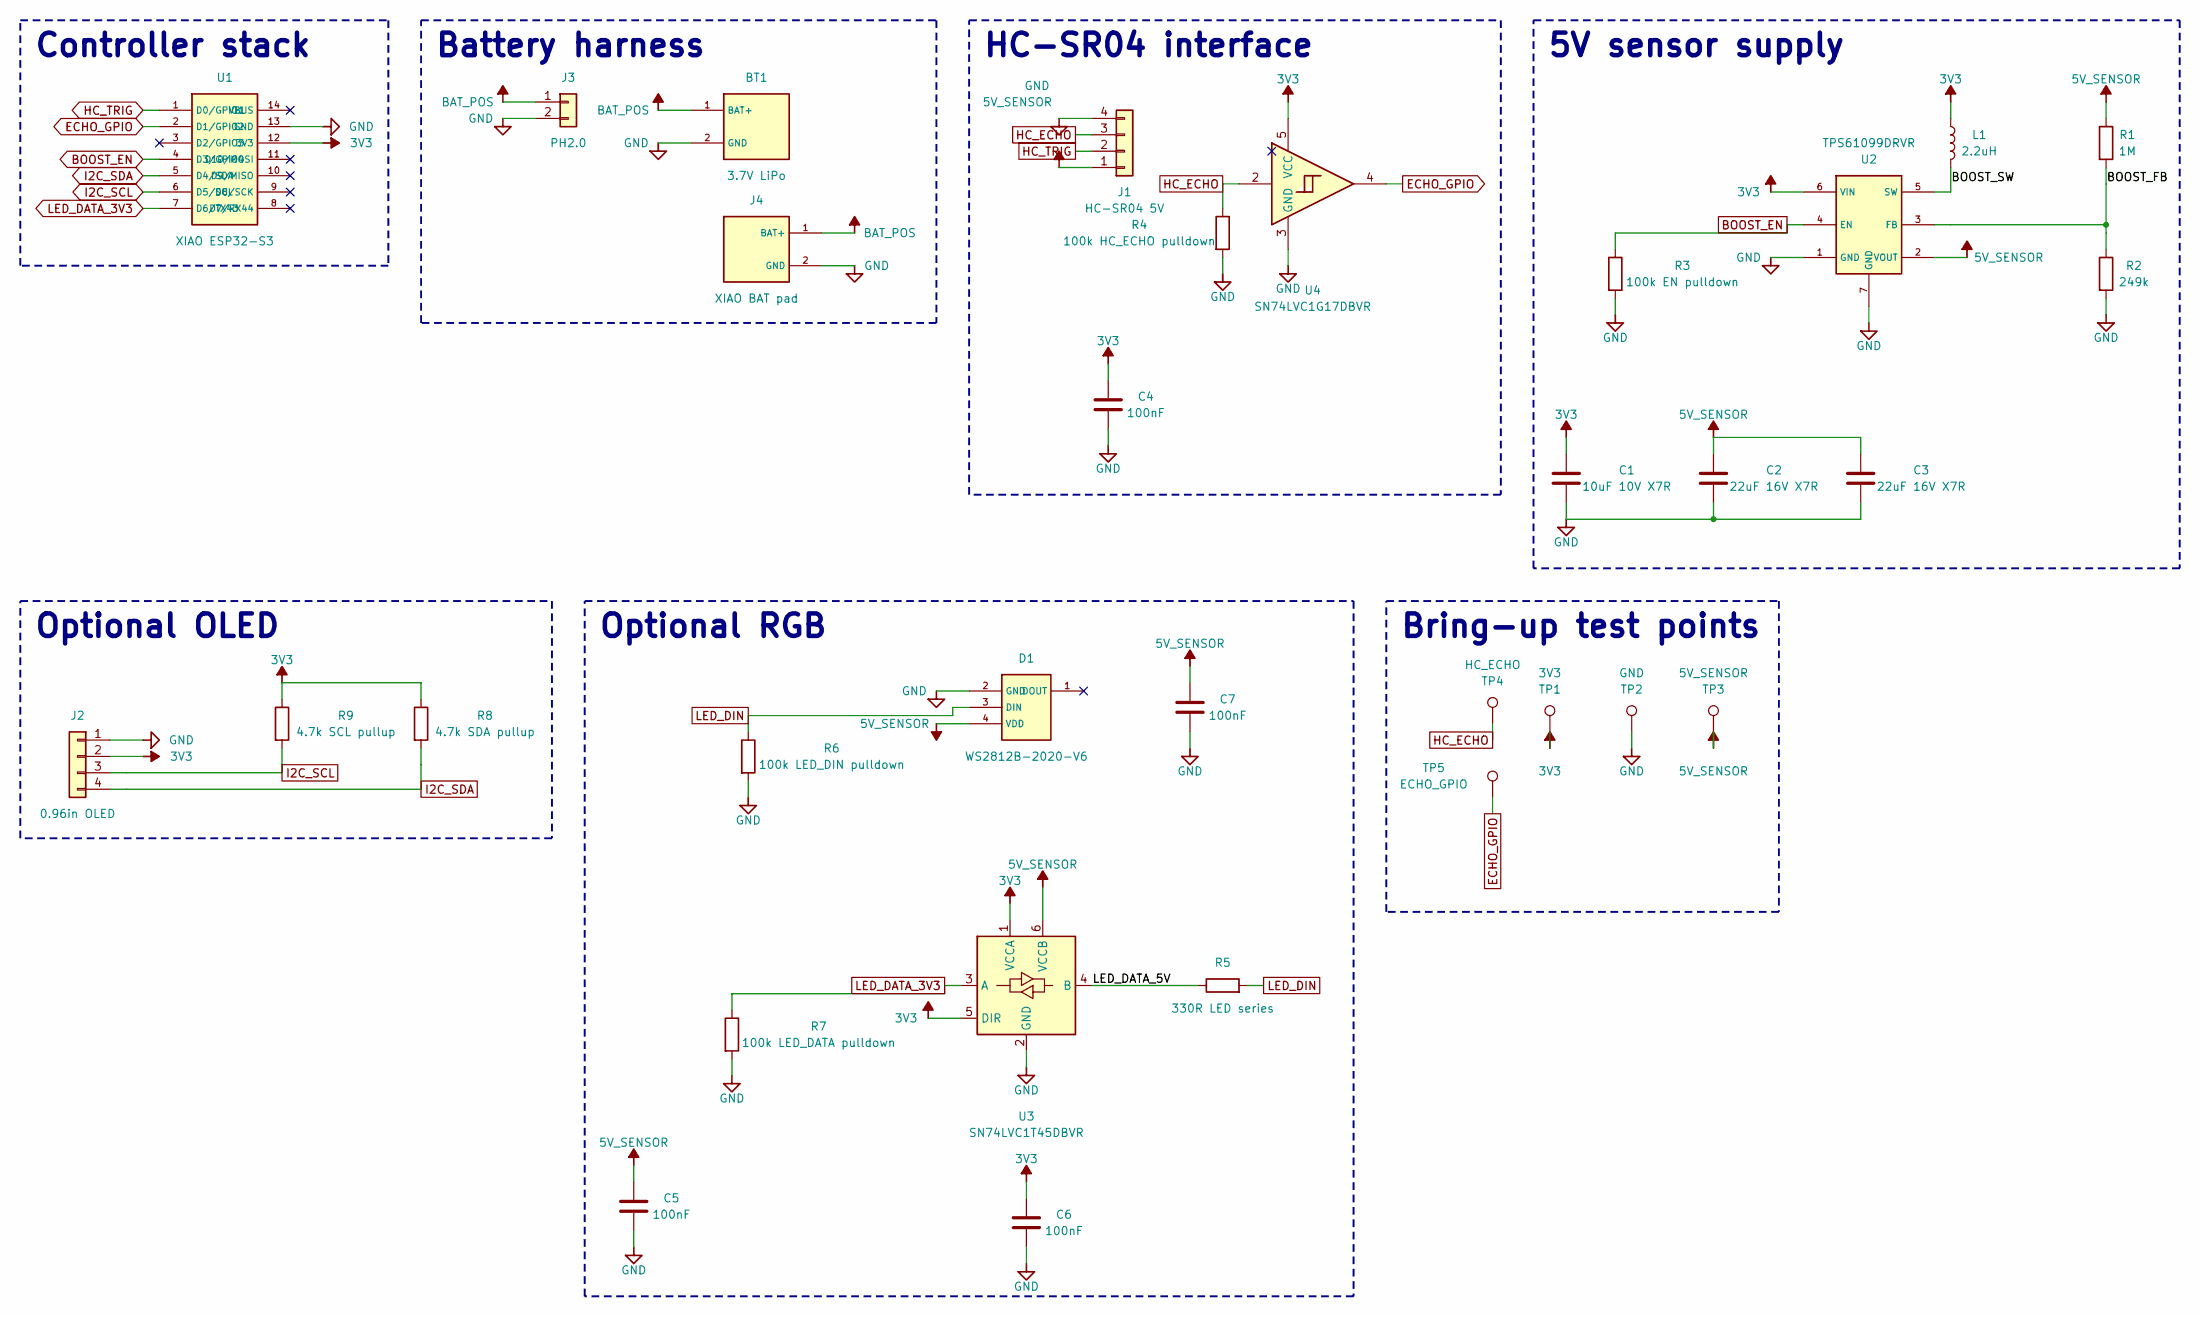
[picture p49: schematic SmartMark.kicad_sch]

Parts:
BT1: 3.7V LiPo
C1: 10uF 10V X7R; C_0805_2012Metric
C2, C3: 22uF 16V X7R; C_1206_3216Metric
C4, C5, C6, C7: 100nF; C_0603_1608Metric
D1: WS2812B-2020-V6; WS2812B_2020_V6
J1: HC-SR04 5V; JST_PH_B4B-PH-K_1x04_P2.00mm_Vertical
J2: 0.96in OLED; PinHeader_1x04_P2.54mm_Vertical
J3: PH2.0
J4: XIAO BAT pad
L1: 2.2uH; VLS3012CX_2R2M
R1: 1M; R_0603_1608Metric
R2: 249k; R_0603_1608Metric
R3: 100k EN pulldown; R_0603_1608Metric
R4: 100k HC_ECHO pulldown; R_0603_1608Metric
R5: 330R LED series; R_0603_1608Metric
R6: 100k LED_DIN pulldown; R_0603_1608Metric
R7: 100k LED_DATA pulldown; R_0603_1608Metric
R8: 4.7k SDA pullup; R_0603_1608Metric
R9: 4.7k SCL pullup; R_0603_1608Metric
TP1: 3V3; TestPoint_Pad_D1.0mm
TP2: GND; TestPoint_Pad_D1.0mm
TP3: 5V_SENSOR; TestPoint_Pad_D1.0mm
TP4: HC_ECHO; TestPoint_Pad_D1.0mm
TP5: ECHO_GPIO; TestPoint_Pad_D1.0mm
U1: XIAO ESP32-S3; XIAO_S3_STACK_SOCKET_2x7
U2: TPS61099DRVR; WSON-6-1EP_2x2mm_P0.65mm_EP1x1.6mm
U3: SN74LVC1T45DBVR; SOT-23-6
U4: SN74LVC1G17DBVR; SOT-23-5

Connections:
3V3: C1.1, C4.1, C6.1, J2.2, L1.1, R8.1, R9.1, TP1.1, U1.12 (3V3), U2.6 (VIN), U3.1 (VCCA), U3.5 (DIR), U4.5 (VCC)
5V_SENSOR: C2.1, C3.1, C5.1, C7.1, D1.4 (VDD), J1.1, R1.1, TP3.1, U2.2 (VOUT), U3.6 (VCCB)
/BOOST_FB: R1.2, R2.1, U2.3 (FB)
/BOOST_SW: L1.2, U2.5 (SW)
/LED_DATA_5V: R5.1, U3.4 (B)
BOOST_EN: R3.1, U1.4 (D3/GPIO4), U2.4 (EN)
ECHO_GPIO: TP5.1, U1.2 (D1/GPIO2), U4.4
GND: BT1.2 (GND), C1.2, C2.2, C3.2, C4.2, C5.2, C6.2, C7.2, D1.2 (GND), J1.4, J2.1, J3.2, J4.2 (GND), R2.2, R3.2, R4.2, R6.2, R7.2, TP2.1, U1.13 (GND), U2.1 (GND), U2.7 (GND), U3.2 (GND), U4.3 (GND)
HC_ECHO: J1.3, R4.1, TP4.1, U4.2
HC_TRIG: J1.2, U1.1 (D0/GPIO1)
I2C_SCL: J2.3, R9.2, U1.6 (D5/SCL)
I2C_SDA: J2.4, R8.2, U1.5 (D4/SDA)
LED_DATA_3V3: R7.1, U1.7 (D6/TX43), U3.3 (A)
LED_DIN: D1.3 (DIN), R5.2, R6.1
unnamed: BT1.1 (BAT+), J3.1, J4.1 (BAT+)

Notes on the sheet:
5V sensor supply
Battery harness
Bring-up test points
Controller stack
HC-SR04 interface
Optional OLED
Optional RGB

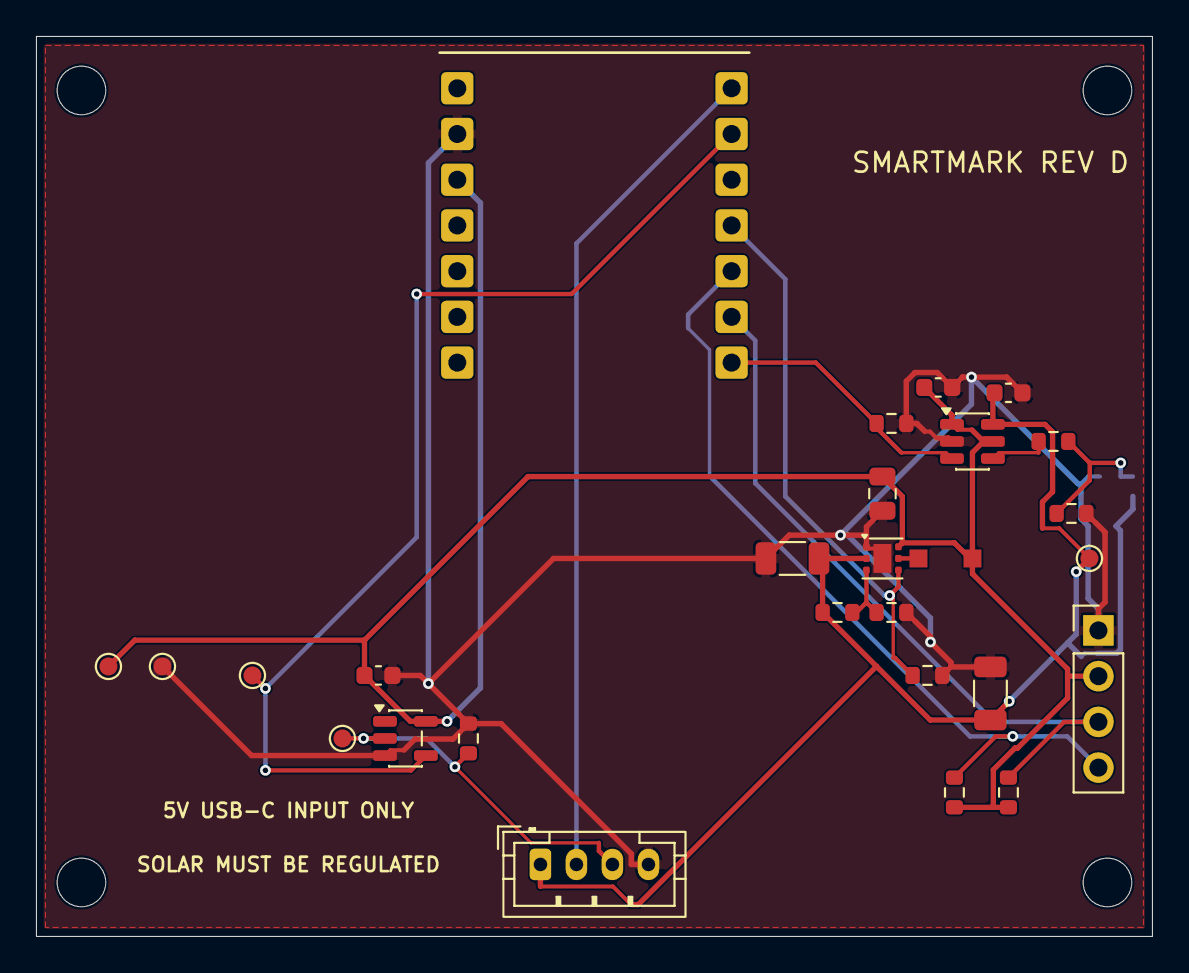
[picture p50: board SmartMark.kicad_pcb from above]

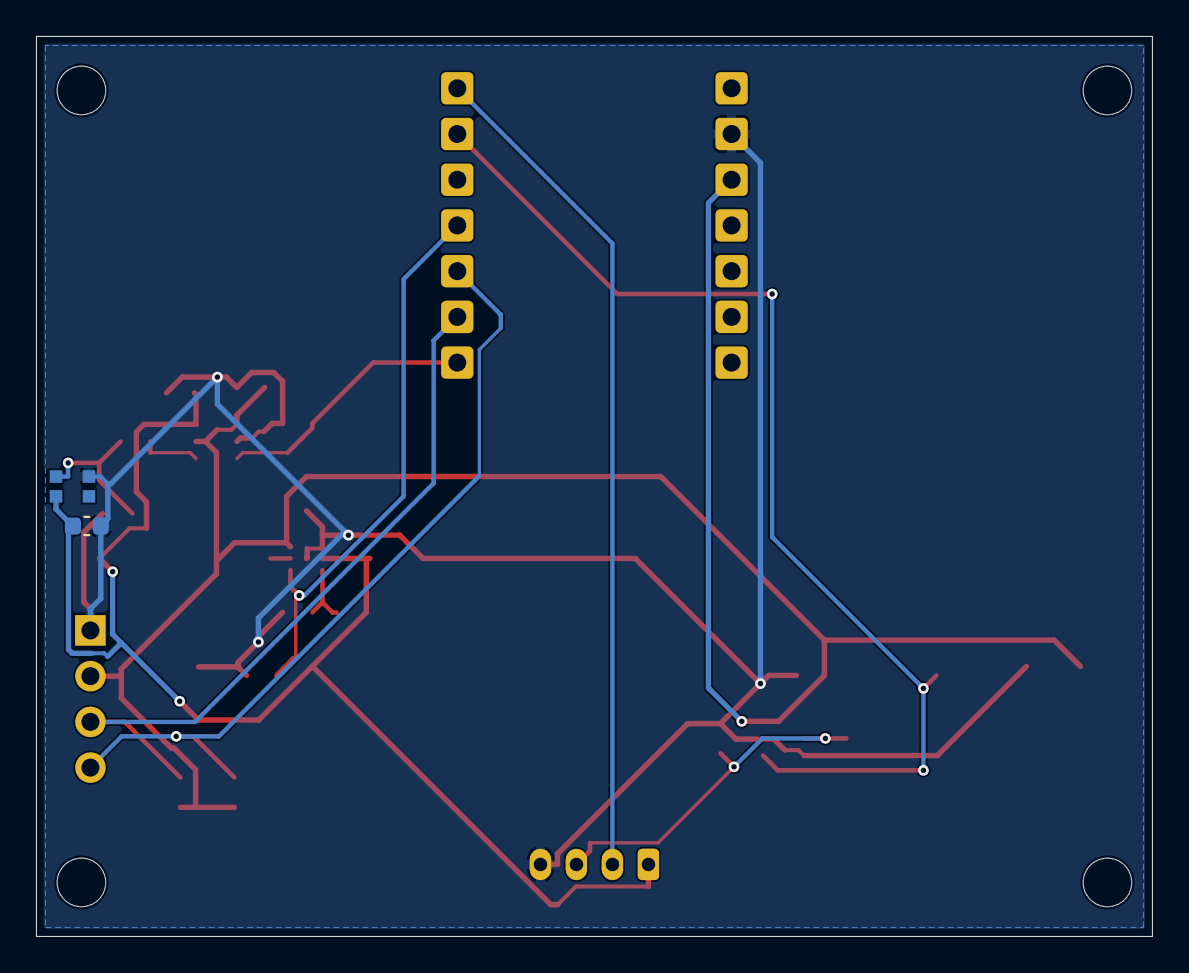
[picture p51: board SmartMark.kicad_pcb from below]

Board: 2 copper layers, 62.0 x 50.0 mm, 33 parts (2 on the bottom side), 14 nets.

Other parts of the board:
H1, H2, H3, H4: M2.5; MountingHole_2.7mm
